the-formless/SmartPlants/PCBs/SlaveNodePCB/SlaveNodePCB.kicad_pcb

## KiCad design PCBs/SlaveNodePCB/SlaveNodePCB.kicad_pcb (2025-12-17)

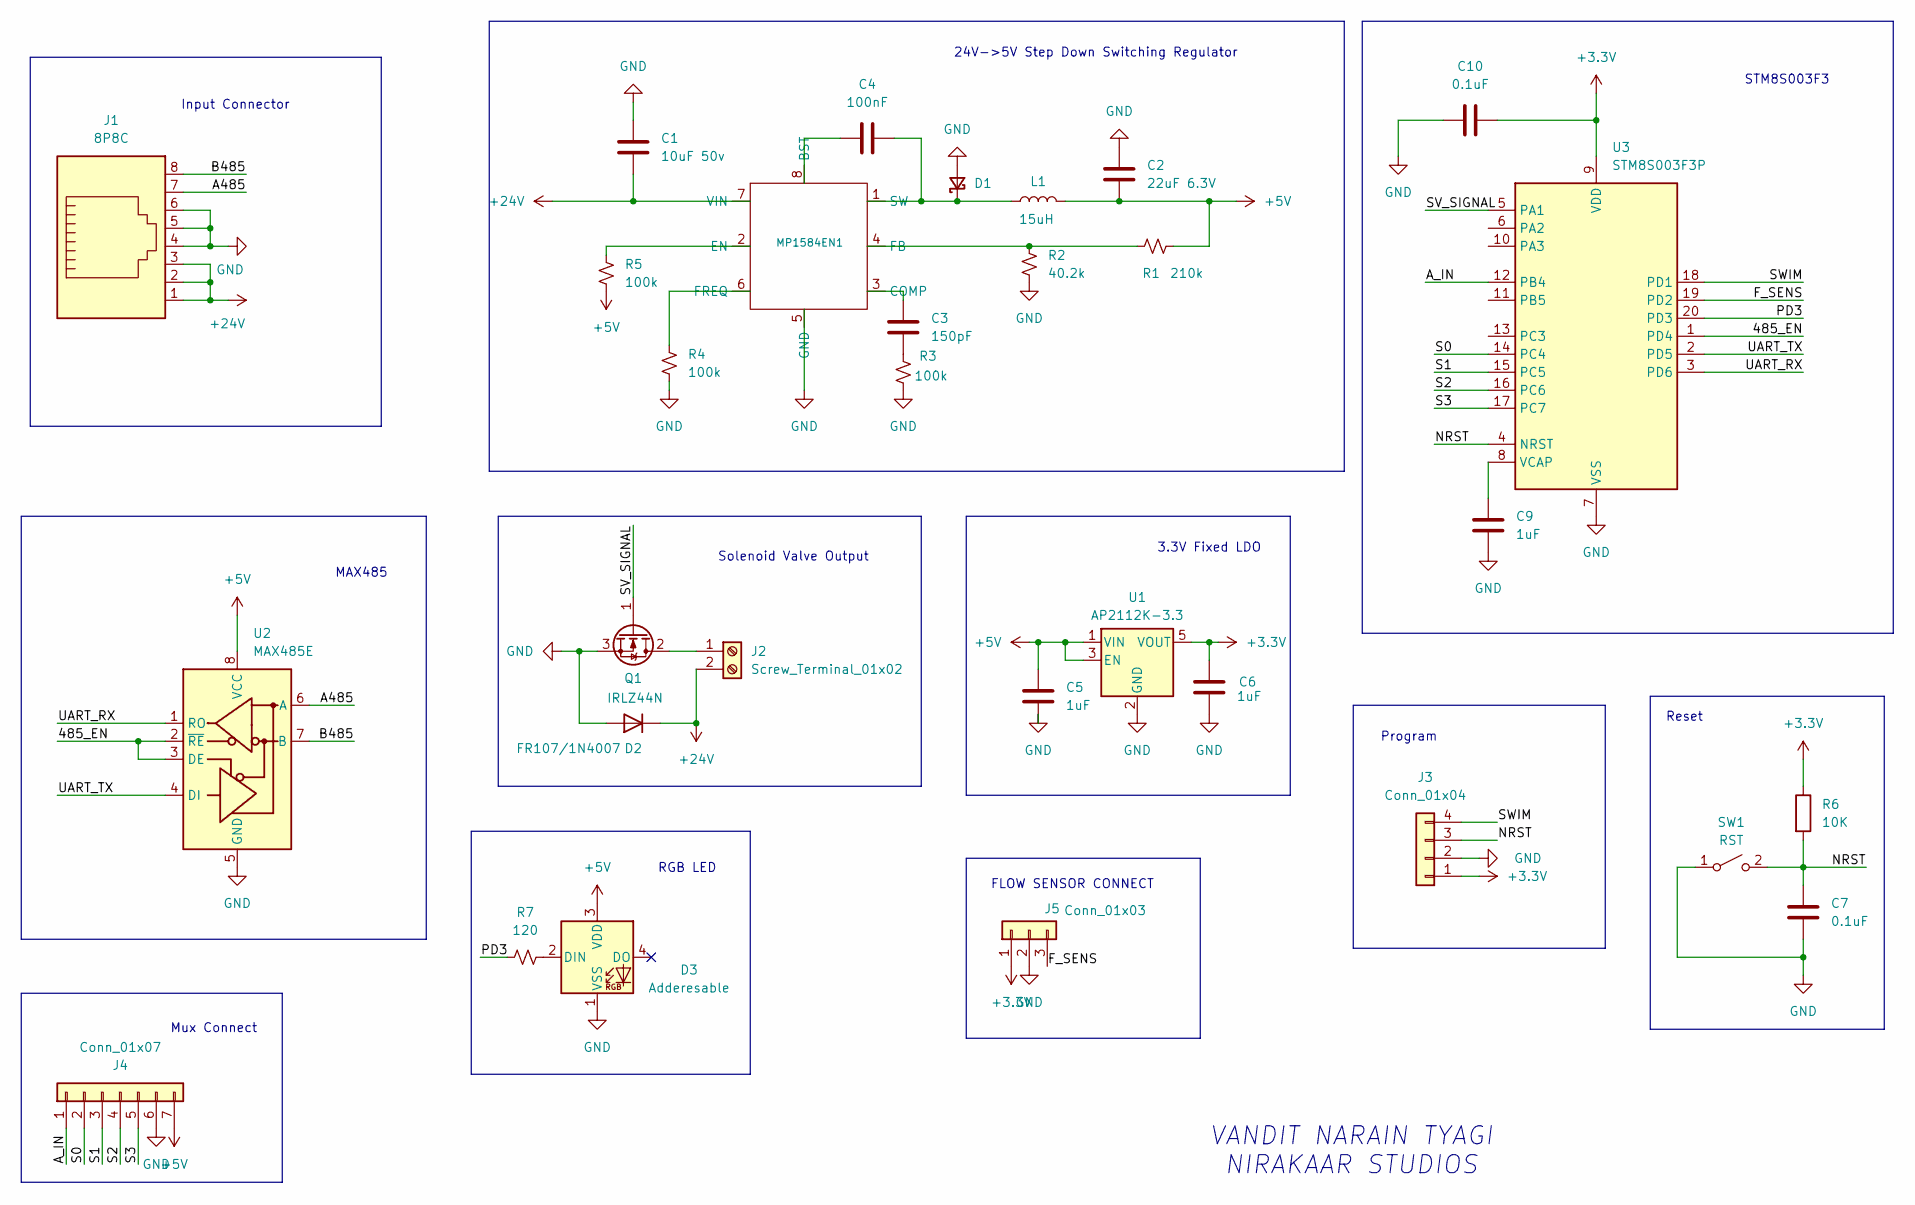
[picture p1: schematic SlaveNodePCB.kicad_sch]

Parts:
C1: 10uF 50v; C_0805_2012Metric
C2: 22uF 6.3V; C_0805_2012Metric
C3: 150pF; C_0805_2012Metric
C4: 100nF; C_0805_2012Metric
C5, C6, C9: 1uF; C_0805_2012Metric
C7, C10: 0.1uF; C_0805_2012Metric
D1: D_SMA-SMB_Universal_Handsoldering
D2: FR107/1N4007; D_DO-41_SOD81_P12.70mm_Horizontal
D3: Adderesable; LED_Inolux_IN-PI554FCH_PLCC4_5.0x5.0mm_P3.2mm
J1: 8P8C; RJ45_Ninigi_GE
J2: Screw_Terminal_01x02; TerminalBlock_Phoenix_MKDS-1,5-2-5.08_1x02_P5.08mm_Horizont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
J3: Conn_01x04; PinHeader_1x04_P2.54mm_Vertical
J4: Conn_01x07; PinHeader_1x07_P2.54mm_Vertical
J5: Conn_01x03; PinHeader_1x03_P2.54mm_Vertical
L1: 15uH; L_Changjiang_FNR8040S
MP1584EN1: SO-8_3.9x4.9mm_P1.27mm
Q1: IRLZ44N; TO-220-3_Vertical
R1: 210k; R_0805_2012Metric
R2: 40.2k; R_0805_2012Metric
R3, R4, R5: 100k; R_0805_2012Metric
R6: 10K; R_0805_2012Metric
R7: 120; R_0805_2012Metric
SW1: RST; SW_PUSH_6mm
U1: AP2112K-3.3; SOT-23-5
U2: MAX485E; SOIC-8_3.9x4.9mm_P1.27mm
U3: STM8S003F3P; TSSOP-20_4.4x6.5mm_P0.65mm

Connections:
+3.3V: C6.1, C10.2, J3.1, J5.1, R6.1, U1.5 (VOUT), U3.9 (VDD)
+5V: C2.2, C5.1, D3.3 (VDD), J4.7, L1.2, R1.2, R5.1, U1.1 (VIN), U1.3 (EN), U2.8 (VCC)
+24V: C1.2, D2.1 (K), J1.1, J1.2, J1.3, J2.2, MP1584EN1.7 (VIN)
/485_EN: U2.2 (~RE), U2.3 (DE), U3.1 (PD4)
/A485: J1.7, U2.6 (A)
/A_IN: J4.1, U3.12 (PB4)
/B485: J1.8, U2.7 (B)
/F_SENS: J5.3, U3.19 (PD2)
/NRST: C7.1, J3.3, R6.2, SW1.2 (B), U3.4 (NRST)
/PD3: R7.1, U3.20 (PD3)
/S0: J4.2, U3.14 (PC4)
/S1: J4.3, U3.15 (PC5)
/S2: J4.4, U3.16 (PC6)
/S3: J4.5, U3.17 (PC7)
/SV_SIGNAL: Q1.1 (G), U3.5 (PA1)
/SWIM: J3.4, U3.18 (PD1)
/UART_RX: U2.1 (RO), U3.3 (PD6)
/UART_TX: U2.4 (DI), U3.2 (PD5)
GND: C1.1, C2.1, C5.2, C6.2, C7.2, C9.2, C10.1, D1.2 (A), D2.2 (A), D3.1 (VSS), J1.4, J1.5, J1.6, J3.2, J4.6, J5.2, MP1584EN1.5 (GND), Q1.3 (S), R2.2, R3.1, R4.2, SW1.1 (A), U1.2 (GND), U2.5 (GND), U3.7 (VSS)
unnamed: C3.2, R3.2
unnamed: C4.2, D1.1 (K), L1.1, MP1584EN1.1 (SW)
unnamed: D3.2 (DIN), R7.2
unnamed: J2.1, Q1.2 (D)
unnamed: C4.1, MP1584EN1.8 (BST)
unnamed: C3.1, MP1584EN1.3 (COMP)
unnamed: MP1584EN1.2 (EN), R5.2
unnamed: MP1584EN1.4 (FB), R1.1, R2.1
unnamed: MP1584EN1.6 (FREQ), R4.1
unnamed: C9.1, U3.8 (VCAP)

Notes on the sheet:
24V->5V Step Down Switching Regulator
Mux Connect
Program
MAX485
Reset
Solenoid Valve Output
Input Connector
VANDIT NARAIN TYAGI NIRAKAAR STUDIOS
RGB LED
FLOW SENSOR CONNECT
STM8S003F3
3.3V Fixed LDO

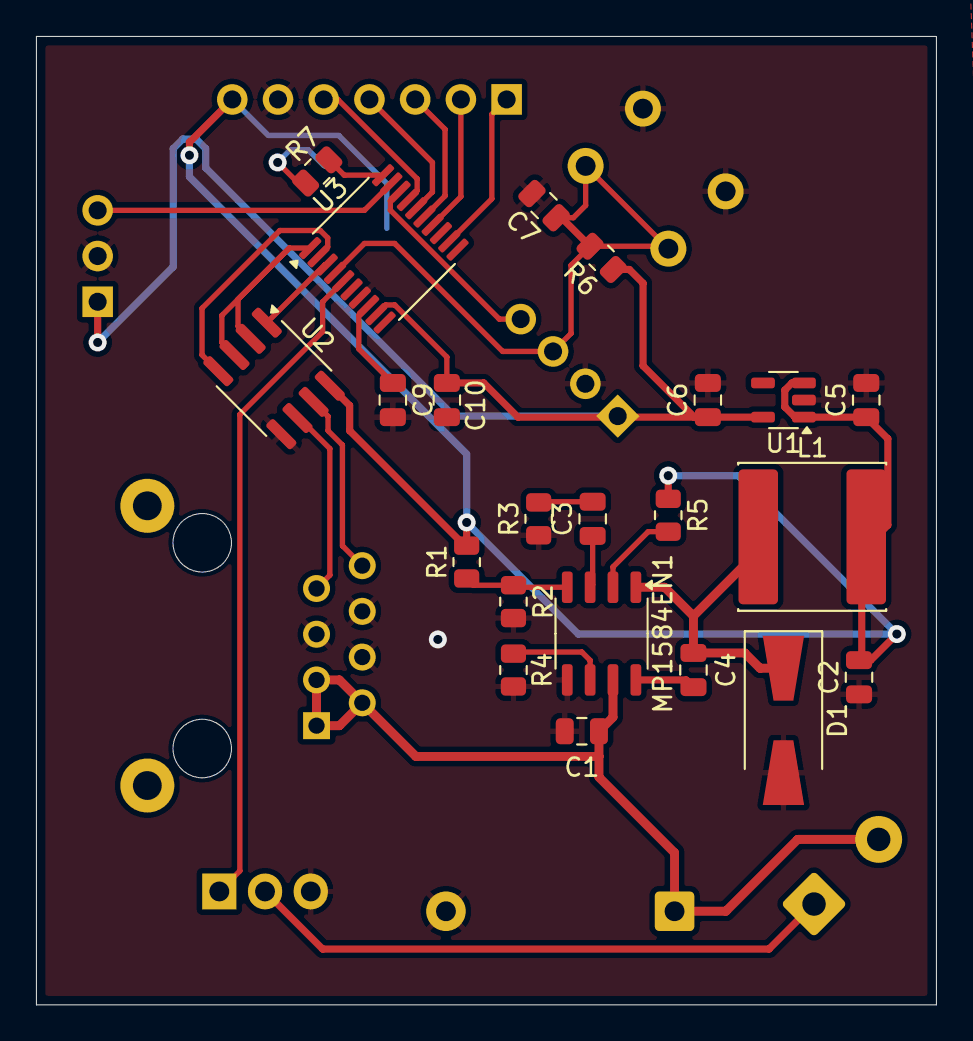
[picture p2: board SlaveNodePCB.kicad_pcb from above]

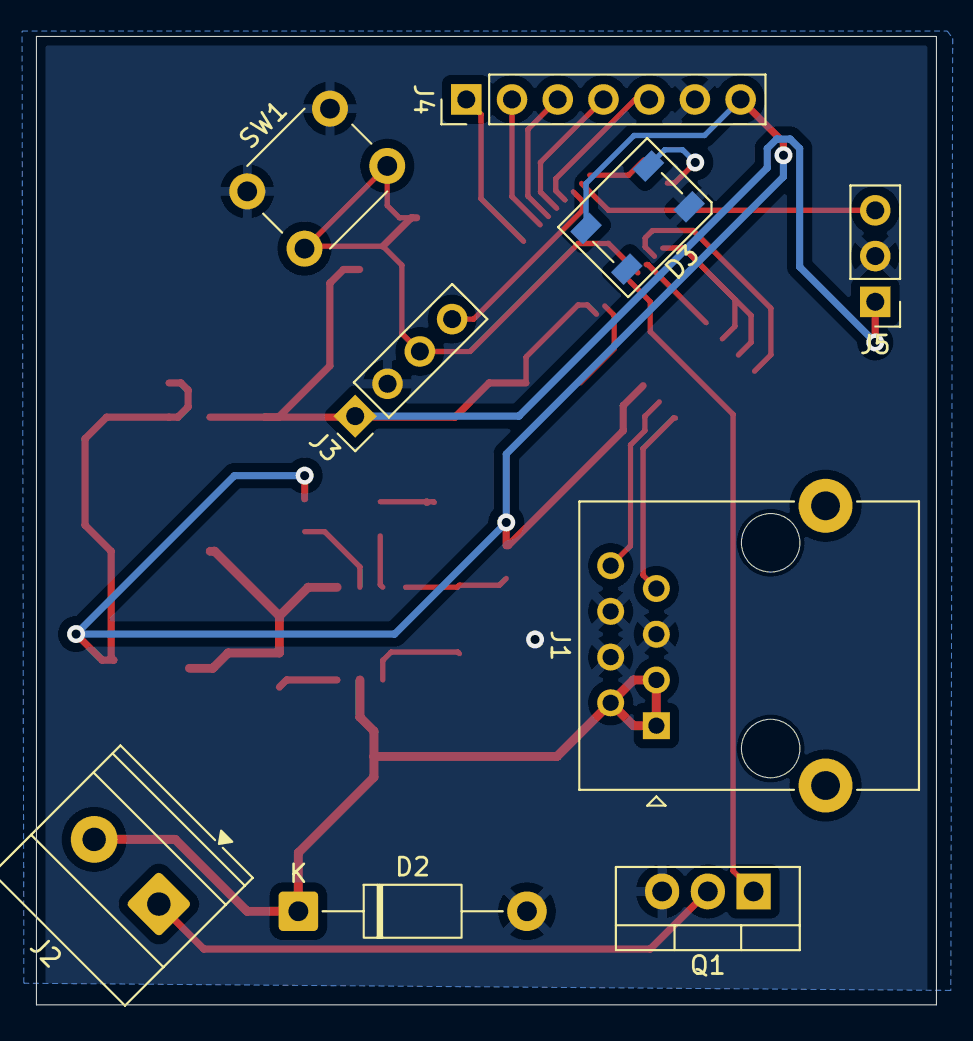
[picture p3: board SlaveNodePCB.kicad_pcb from below]

Board: 2 copper layers, 50.0 x 53.8 mm, 31 parts (9 on the bottom side), 29 nets.
