the-formless/SmartPlants/(commit log)

2025-11-26 LED Blink Test with custom HAL
2025-11-26 fixed GPIO mode definitions and in gpio hal.h and fixed implementation in led.c
2025-11-27 Added checks for True Open Drain Ports and forced Correct Initialization
    [gpio.c, gpio.h]
2025-11-28 Implemented UART and tested with arduino. TX works. RX not working properly
    [main.c, uart.c, uart.h]
2025-11-28 It sends and read. Read is limited to only 1 character. Interrupts will solve this
2025-11-28 ISR works and can now send and receive data from arduino
2025-12-02 Added PCB directory and Slave PCB project
    [SlaveNodePCB.kicad_pcb, SlaveNodePCB.kicad_sch]
2025-12-03 Designed Slave PCB schematic
    [SlaveNodePCB.kicad_pcb, SlaveNodePCB.kicad_sch]
2025-12-05 First Slave PCB Design Complete
    [SlaveNodePCB.kicad_sch]
2025-12-17 Current Slave PCB
    [SlaveNodePCB.kicad_pcb, SlaveNodePCB.kicad_sch]
